PedroHSCoelho/IOT/diagrama/Descrições dos blocos.png

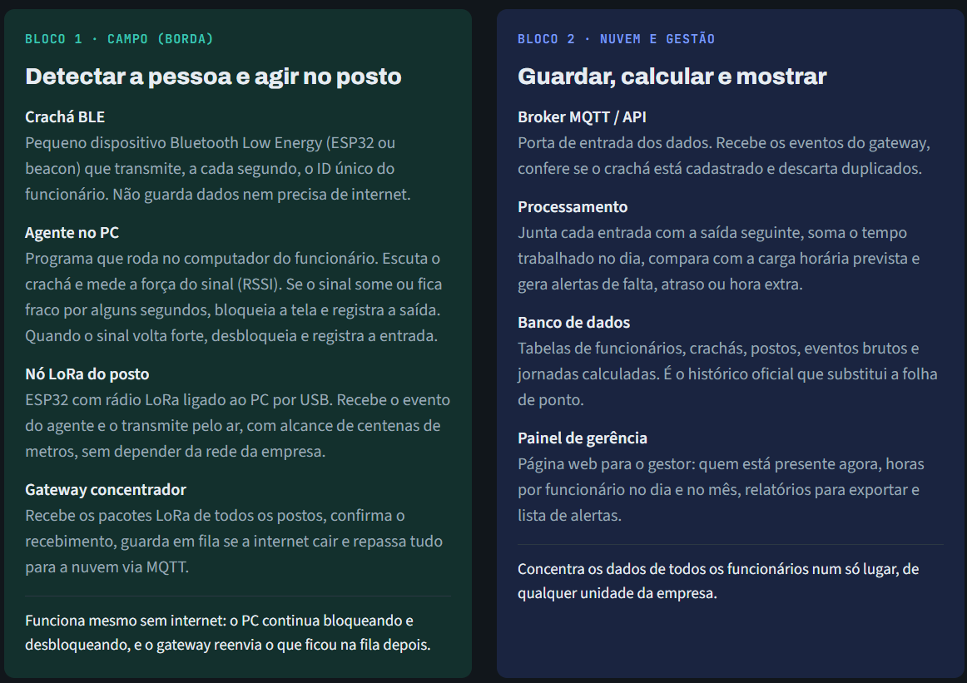
diagrama/Descrições dos blocos.png
