PedroHSCoelho/IOT/diagrama/Diagrama blocos.png

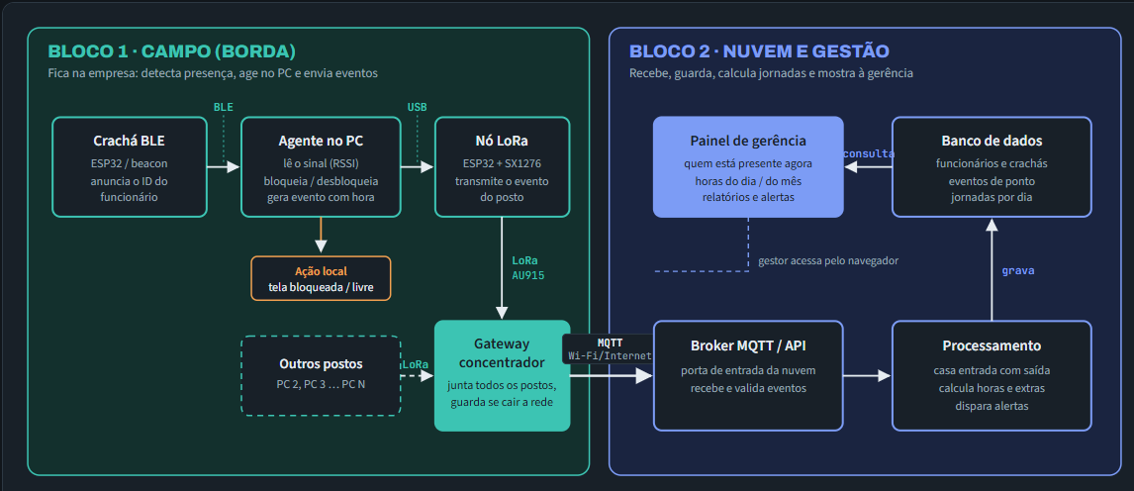
diagrama/Diagrama blocos.png
