PedroHSCoelho/IOT/(commit log)

2026-11-03 Renomeia READ.me para README.md e atualiza documentação
    README com visão geral e mapa de arquivos; PENDENCIAS.md e CLAUDE.md
    passam a refletir que o repositório já existe no GitHub.
2026-11-04 Adiciona ACK de comandos, estado do gateway no painel e simuladores
    - Fluxo 5: o crachá confirma comandos em unifesp/ponto/cmd/{badge}/ack;
    comando.status vira CONFIRMADO/FALHOU e o OTA grava firmware_versao.
    - 04_usuarios.sql: nodered pode atualizar dispositivo.firmware_versao
    (testes S1 ajustados; 31/31 checks ok).
    - Painel: linha do gateway (online/offline, RSSI, SNR) a partir da
    mensagem retained e do Last Will em unifesp/ponto/gateway/status.
    - publicar_teste.mjs: modos "ack" e "gateway" (online/offline/cair).
    - T10: contagem de vw_historico igual antes e depois de reiniciar o Node-RED.
    - PENDENCIAS.md e README do servidor atualizados.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
2026-11-12 Registra que a bateria CR2032 do DS1302 ainda nao chegou
2026-11-12 Adiciona teste 5 (BLE: anuncio do cracha e leitura de RSSI no PC) e define o foco atual
2026-11-13 Adiciona gateway MQTT (teste 6) e cracha de teste por PRG (teste 7); registra medicoes de RSSI
2026-11-13 Adiciona agente de bloqueio por BLE (tela propria, limiar ~1 m)
2026-11-13 Novo fluxo: o botao do cracha desbloqueia o PC e o afastamento bloqueia (agente v2)
    - firmware 05: anuncio BLE com boot + contador de cliques, anuncio rapido apos o clique
    - agente_bloqueio.py v2: clique libera (RSSI do pacote), pico da janela bloqueia, aviso de 5 s
    - o PC nao registra ponto (origem ble sem uso); modelo de dados inalterado
    - docs: FLUXO_BLE_E_BLOQUEIO.md e DIARIO_DE_BORDO.md (base do relatorio)
    - README, CLAUDE.md, PENDENCIAS.md, BANCO_DE_DADOS.md e README do servidor atualizados
2026-11-13 Adiciona secao de retomada (de onde continuar) e registra fim da sessao
